FakeApate/pager-kicad/meshpager.kicad_pcb

## KiCad design meshpager.kicad_pcb (2026-08-29)

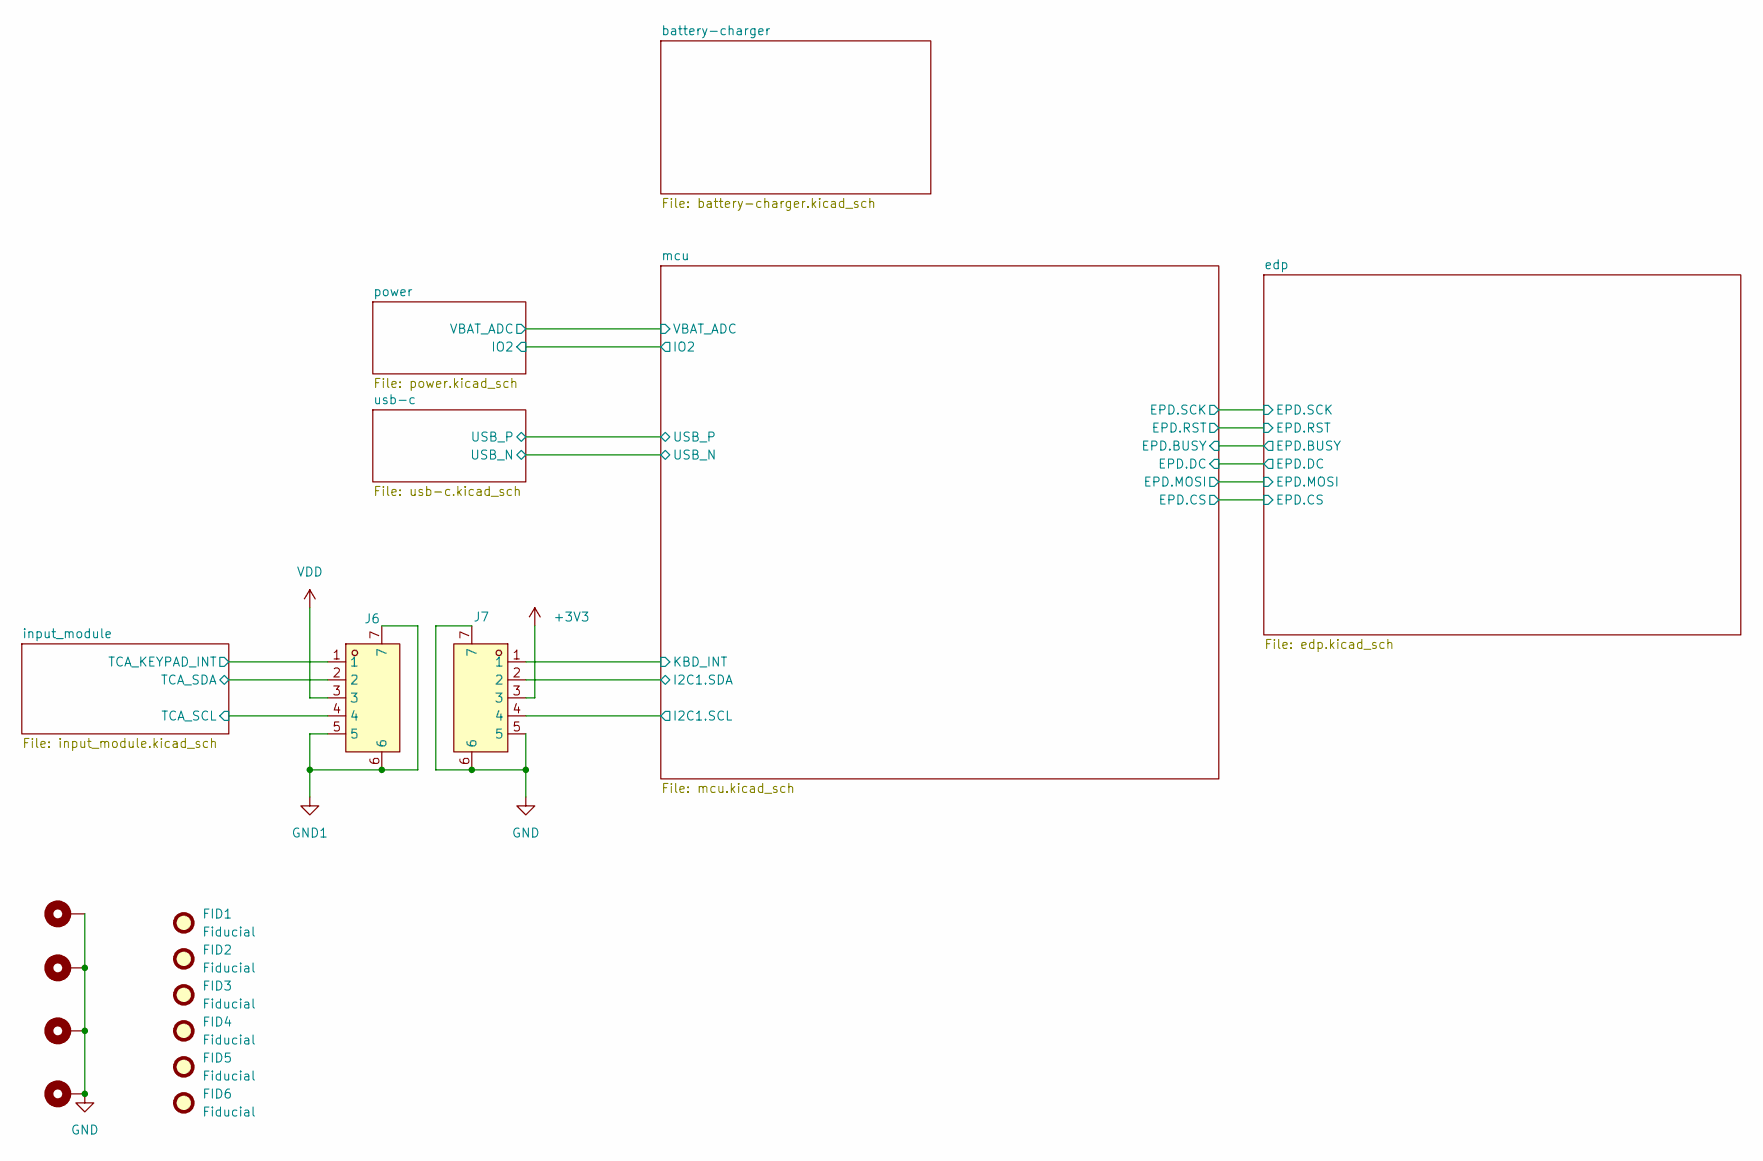
[picture p1: schematic meshpager.kicad_sch]

Parts:
FID1, FID2, FID3, FID4, FID5, FID6: Fiducial; Fiducial_1mm_Mask3mm
H5, H6, H7, H8: MountingHole_Pad; MountingHole_2.7mm_M2.5_Pad
J6, J7: HC-FPC-05-09-5RLTAG; CONN-SMD_5P-P0.50_HCTL_HC-FPC-05-09-5RLTAG; MPN HC-FPC-05-09-5RLTAG; LCSC Part C5213747

Connections:
+3V3: J7.3; also elsewhere on the board
/input_module/INT: J6.1; also elsewhere on the board
/input_module/TCA_SCL: J6.4; also elsewhere on the board
/input_module/TCA_SDA: J6.2; also elsewhere on the board
/mcu/I2C1.SCL: J7.4; also elsewhere on the board
/mcu/I2C1.SDA: J7.2; also elsewhere on the board
/mcu/KBD_INT: J7.1; also elsewhere on the board
GND: H5.1 (1_1), H6.1 (1_1), H7.1 (1_1), H8.1 (1_1), J7.5, J7.6, J7.7; also elsewhere on the board
GND1: J6.5, J6.6, J6.7; also elsewhere on the board
VDD: J6.3; also elsewhere on the board

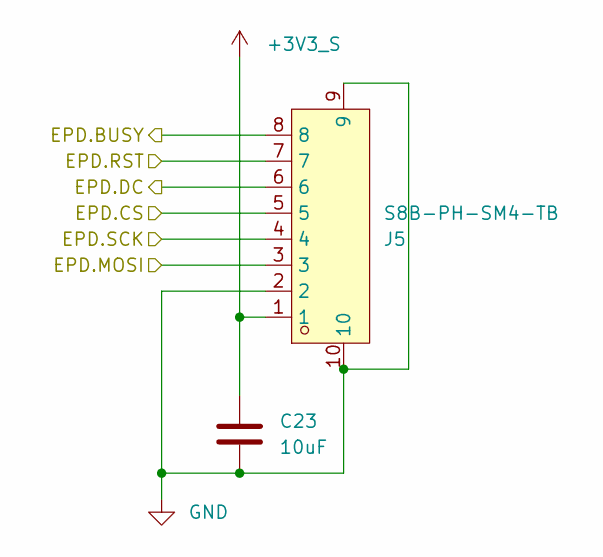
[picture p2: schematic edp.kicad_sch, Meshpager]

Parts:
C23: 10uF; C_0603_1608Metric; LCSC C19702
J5: S8B-PH-SM4-TB; CONN-SMD_8P-P2.00_S8B-PH-SM4-TB-LF-SN; MPN S8B-PH-SM4-TB(LF)(SN); LCSC Part C265121

Connections:
+3V3_S: C23.1, J5.1; also elsewhere on the board
/edp/EPD.BUSY: J5.8; also elsewhere on the board
/edp/EPD.CS: J5.5; also elsewhere on the board
/edp/EPD.DC: J5.6; also elsewhere on the board
/edp/EPD.MOSI: J5.3; also elsewhere on the board
/edp/EPD.RST: J5.7; also elsewhere on the board
/edp/EPD.SCK: J5.4; also elsewhere on the board
GND: C23.2, J5.2, J5.9, J5.10; also elsewhere on the board

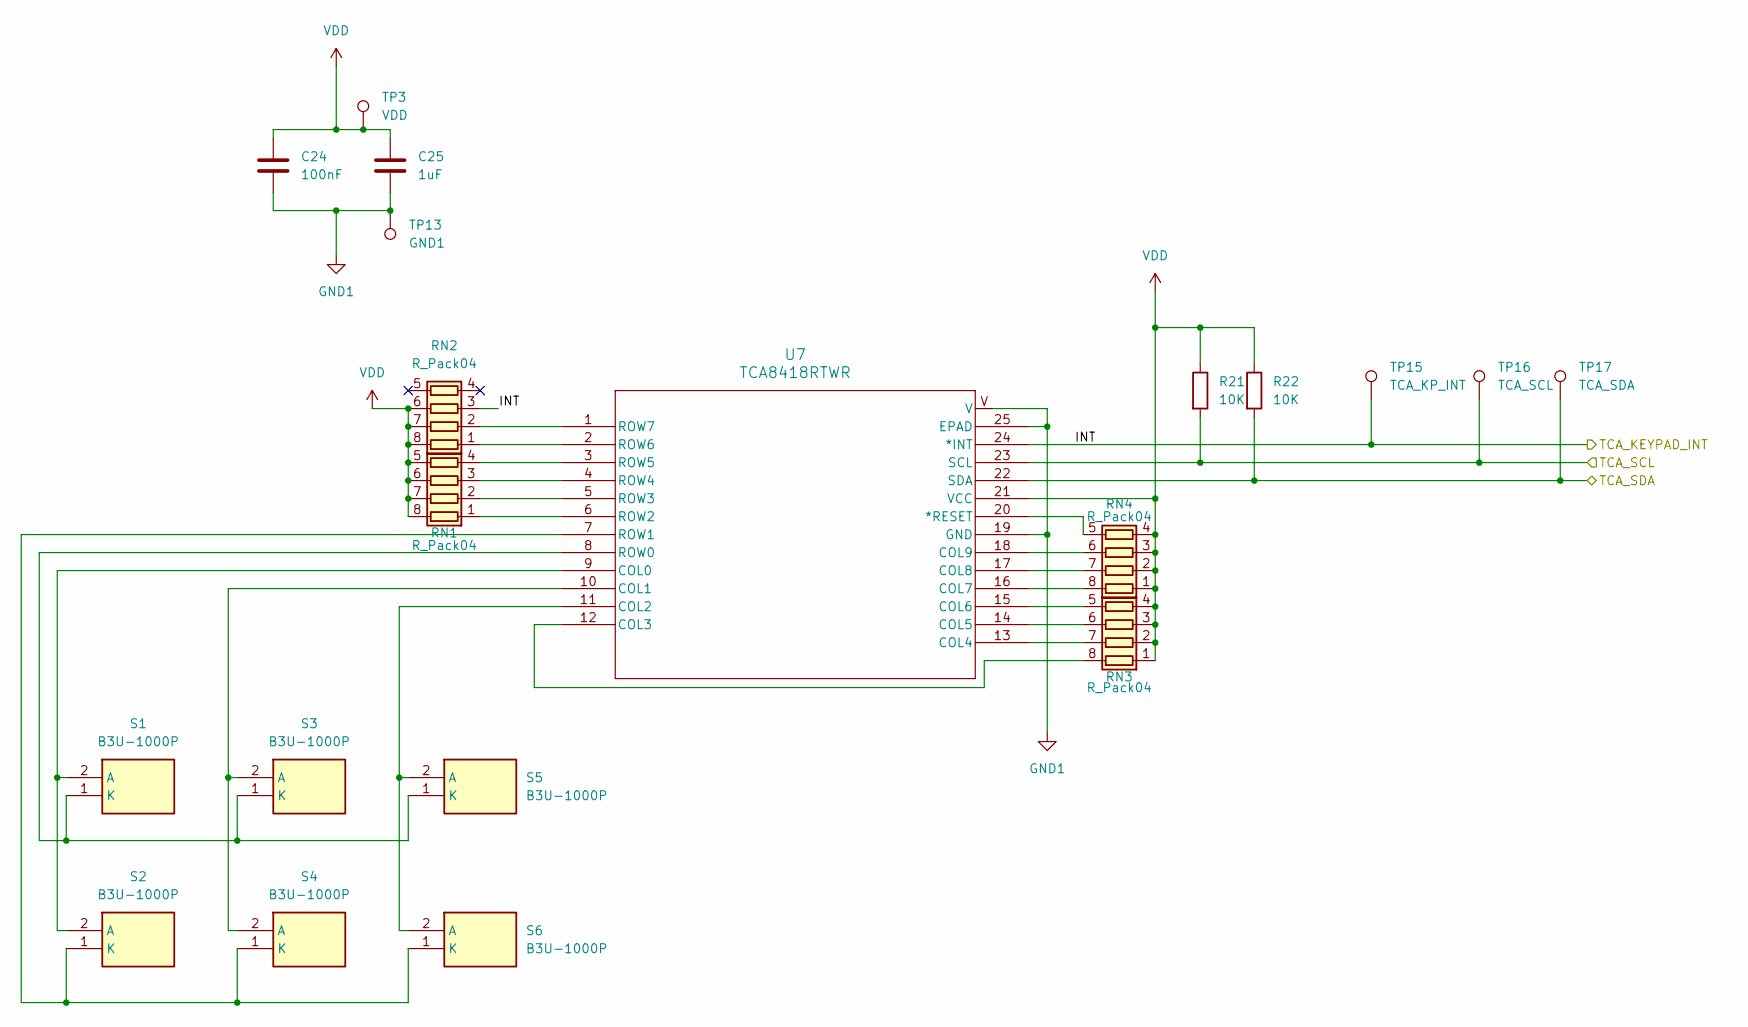
[picture p3: schematic input_module.kicad_sch, Meshpager]

Parts:
C24: 100nF; C_0402_1005Metric; LCSC C1525
C25: 1uF; C_0603_1608Metric; LCSC C15849
R21, R22: 10K; R_0402_1005Metric; LCSC C25744
RN1, RN2, RN3, RN4: R_Pack04; R_Array_Convex_4x0603; LCSC C29718
S1, S2, S3, S4, S5, S6: B3U-1000P; Mouser Part Number 653-B3U-1000P
TP3: VDD; TestPoint_Pad_D1.5mm
TP13: GND1; TestPoint_Pad_D1.5mm
TP15: TCA_KP_INT; TestPoint_Pad_D1.5mm
TP16: TCA_SCL; TestPoint_Pad_D1.5mm
TP17: TCA_SDA; TestPoint_Pad_D1.5mm
U7: TCA8418RTWR; WQFN-24-1EP_4x4mm_P0.5mm_EP2.45x2.45mm; LCSC C138713

Connections:
/input_module/INT: RN2.3 (R3.1), TP15.1 (1_1), U7.24 (*INT); also elsewhere on the board
/input_module/TCA_SCL: R21.2, TP16.1 (1_1), U7.23 (SCL); also elsewhere on the board
/input_module/TCA_SDA: R22.2, TP17.1 (1_1), U7.22 (SDA); also elsewhere on the board
GND1: C24.2, C25.2, TP13.1 (1_1), U7.19 (GND), U7.25 (EPAD), U7.V; also elsewhere on the board
unnamed: RN1.1 (R1.1), U7.6 (ROW2)
unnamed: RN1.2 (R2.1), U7.5 (ROW3)
unnamed: RN1.3 (R3.1), U7.4 (ROW4)
unnamed: RN1.4 (R4.1), U7.3 (ROW5)
unnamed: RN2.1 (R1.1), U7.2 (ROW6)
unnamed: RN2.2 (R2.1), U7.1 (ROW7)
unnamed: RN3.8 (R1.2), U7.12 (COL3)
unnamed: RN3.7 (R2.2), U7.13 (COL4)
unnamed: RN3.6 (R3.2), U7.14 (COL5)
unnamed: RN3.5 (R4.2), U7.15 (COL6)
unnamed: RN4.8 (R1.2), U7.16 (COL7)
unnamed: RN4.7 (R2.2), U7.17 (COL8)
unnamed: RN4.6 (R3.2), U7.18 (COL9)
unnamed: RN4.5 (R4.2), U7.20 (*RESET)
unnamed: S1.2 (A), S2.2 (A), U7.9 (COL0)
unnamed: S1.1 (K), S3.1 (K), S5.1 (K), U7.8 (ROW0)
unnamed: S2.1 (K), S4.1 (K), S6.1 (K), U7.7 (ROW1)
unnamed: S3.2 (A), S4.2 (A), U7.10 (COL1)
unnamed: S5.2 (A), S6.2 (A), U7.11 (COL2)
VDD: C24.1, C25.1, R21.1, R22.1, RN1.5 (R4.2), RN1.6 (R3.2), RN1.7 (R2.2), RN1.8 (R1.2), RN2.6 (R3.2), RN2.7 (R2.2), RN2.8 (R1.2), RN3.1 (R1.1), RN3.2 (R2.1), RN3.3 (R3.1), RN3.4 (R4.1), RN4.1 (R1.1), RN4.2 (R2.1), RN4.3 (R3.1), RN4.4 (R4.1), TP3.1 (1_1), U7.21 (VCC); also elsewhere on the board

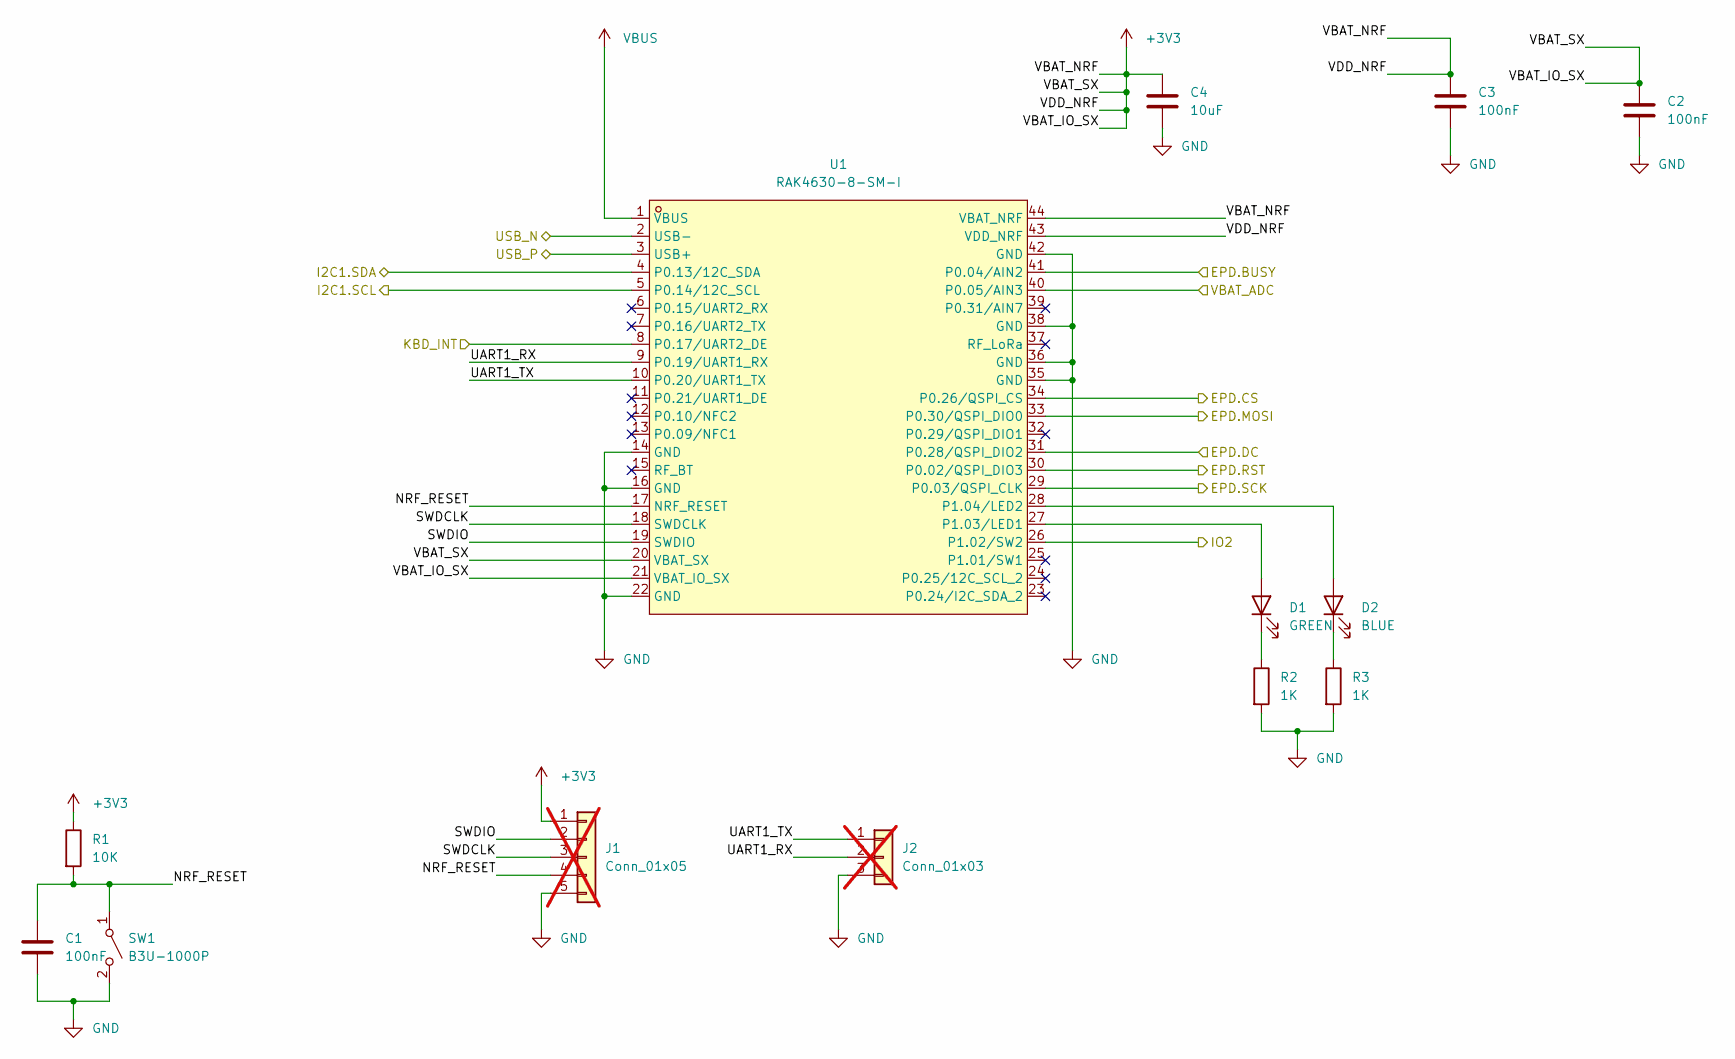
[picture p4: schematic mcu.kicad_sch, Meshpager]

Parts:
C1, C2, C3: 100nF; C_0402_1005Metric; LCSC C1525
C4: 10uF; C_0603_1608Metric; LCSC C19702
D1: GREEN; LED_0603_1608Metric; LCSC C12624
D2: BLUE; LED_0603_1608Metric; LCSC C2288
J1: Conn_01x05; PinHeader_1x05_P1.27mm_Vertical; not fitted
J2: Conn_01x03; PinHeader_1x03_P1.27mm_Vertical; not fitted
R1: 10K; R_0402_1005Metric; LCSC C25744
R2, R3: 1K; R_0402_1005Metric; LCSC C11702
SW1: B3U-1000P; LCSC C231329
U1: RAK4630-8-SM-I; COMM-SMD_44P-L23.0-W15.0-P1.20_RAK4630-8-SM-I; MPN RAk4630-8-SM-I; LCSC Part C32315253

Connections:
+3V3: C2.1, C3.1, C4.1, J1.1, R1.1, U1.20 (VBAT_SX), U1.21 (VBAT_IO_SX), U1.43 (VDD_NRF), U1.44 (VBAT_NRF); also elsewhere on the board
/edp/EPD.BUSY: U1.41 (P0.04/AIN2); also elsewhere on the board
/edp/EPD.CS: U1.34 (P0.26/QSPI_CS); also elsewhere on the board
/edp/EPD.DC: U1.31 (P0.28/QSPI_DIO2); also elsewhere on the board
/edp/EPD.MOSI: U1.33 (P0.30/QSPI_DIO0); also elsewhere on the board
/edp/EPD.RST: U1.30 (P0.02/QSPI_DIO3); also elsewhere on the board
/edp/EPD.SCK: U1.29 (P0.03/QSPI_CLK); also elsewhere on the board
/mcu/I2C1.SCL: U1.5 (P0.14/12C_SCL); also elsewhere on the board
/mcu/I2C1.SDA: U1.4 (P0.13/12C_SDA); also elsewhere on the board
/mcu/IO2: U1.26 (P1.02/SW2); also elsewhere on the board
/mcu/KBD_INT: U1.8 (P0.17/UART2_DE); also elsewhere on the board
/mcu/NRF_RESET: C1.1, J1.4, R1.2, SW1.1 (A), U1.17 (NRF_RESET)
/mcu/SWDCLK: J1.3, U1.18 (SWDCLK)
/mcu/SWDIO: J1.2, U1.19 (SWDIO)
/mcu/UART1_RX: J2.2, U1.9 (P0.19/UART1_RX)
/mcu/UART1_TX: J2.1, U1.10 (P0.20/UART1_TX)
/mcu/USB_N: U1.2 (USB-); also elsewhere on the board
/mcu/USB_P: U1.3 (USB+); also elsewhere on the board
/mcu/VBAT_ADC: U1.40 (P0.05/AIN3); also elsewhere on the board
GND: C1.2, C2.2, C3.2, C4.2, J1.5, J2.3, R2.2, R3.2, SW1.2 (B), U1.14 (GND), U1.16 (GND), U1.22 (GND), U1.35 (GND), U1.36 (GND), U1.38 (GND), U1.42 (GND); also elsewhere on the board
unnamed: D1.2 (A), U1.27 (P1.03/LED1)
unnamed: D1.1 (K), R2.1
unnamed: D2.2 (A), U1.28 (P1.04/LED2)
unnamed: D2.1 (K), R3.1
VBUS: U1.1 (VBUS); also elsewhere on the board

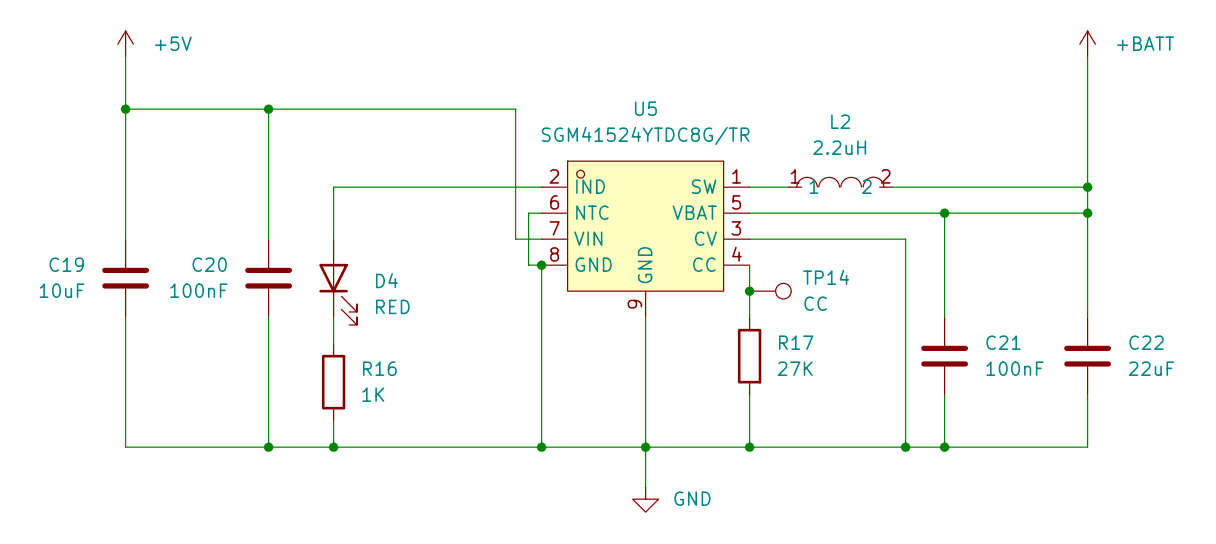
[picture p5: schematic battery-charger.kicad_sch, Meshpager]

Parts:
C19: 10uF; C_0603_1608Metric; LCSC C19702
C20, C21: 100nF; C_0402_1005Metric; LCSC C1525
C22: 22uF; C_0805_2012Metric; LCSC C45783
D4: RED; LED_0603_1608Metric; LCSC C2286
L2: 2.2uH; IND-SMD_L3.0-W3.0_SWPA3010S; MPN SWPA3012S2R2MT; LCSC Part C36402
R16: 1K; R_0402_1005Metric; LCSC C11702
R17: 27K; R_0402_1005Metric; LCSC C2933084
TP14: CC; TestPoint_Pad_D1.5mm
U5: SGM41524YTDC8G/TR; DFN-8_L3.0-W2.0-P0.50-TL-EP-1; MPN SGM41524YTDC8G/TR; LCSC Part C699852

Connections:
+5V: C19.2, C20.1, U5.7 (VIN); also elsewhere on the board
+BATT: C21.1, C22.2, L2.2, U5.5 (VBAT); also elsewhere on the board
GND: C19.1, C20.2, C21.2, C22.1, R16.1, R17.2, U5.3 (CV), U5.6 (NTC), U5.8 (GND), U5.9 (GND); also elsewhere on the board
unnamed: D4.2 (A), U5.2 (IND)
unnamed: D4.1 (K), R16.2
unnamed: R17.1, TP14.1 (1_1), U5.4 (CC)
unnamed: L2.1, U5.1 (SW)

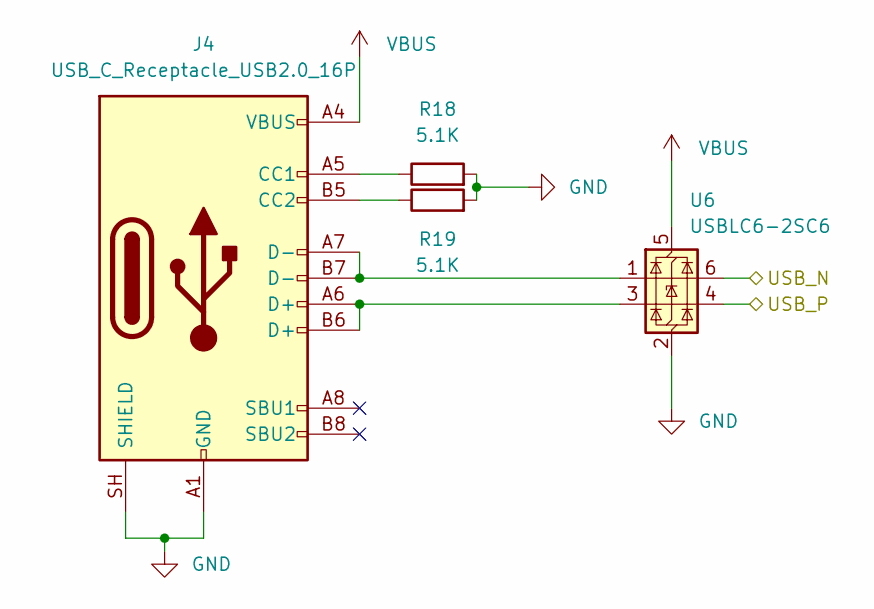
[picture p6: schematic usb-c.kicad_sch, Meshpager]

Parts:
J4: USB_C_Receptacle_USB2.0_16P; USB_C_Receptacle_G-Switch_GT-USB-7010ASV; LCSC Part C2988369
R18, R19: 5.1K; R_0402_1005Metric; LCSC C25905
U6: USBLC6-2SC6; SOT-23-6; LCSC C7519

Connections:
/mcu/USB_N: U6.6 (I/O1); also elsewhere on the board
/mcu/USB_P: U6.4 (I/O2); also elsewhere on the board
GND: J4.A1 (GND), J4.A12 (GND), J4.B1 (GND), J4.B12 (GND), J4.SH (SHIELD), R18.2, R19.2, U6.2 (GND); also elsewhere on the board
unnamed: J4.A5 (CC1), R18.1
unnamed: J4.B5 (CC2), R19.1
unnamed: J4.A6 (D+), J4.B6 (D+), U6.3 (I/O2)
unnamed: J4.A7 (D-), J4.B7 (D-), U6.1 (I/O1)
VBUS: J4.A4 (VBUS), J4.A9 (VBUS), J4.B4 (VBUS), J4.B9 (VBUS), U6.5 (VBUS); also elsewhere on the board

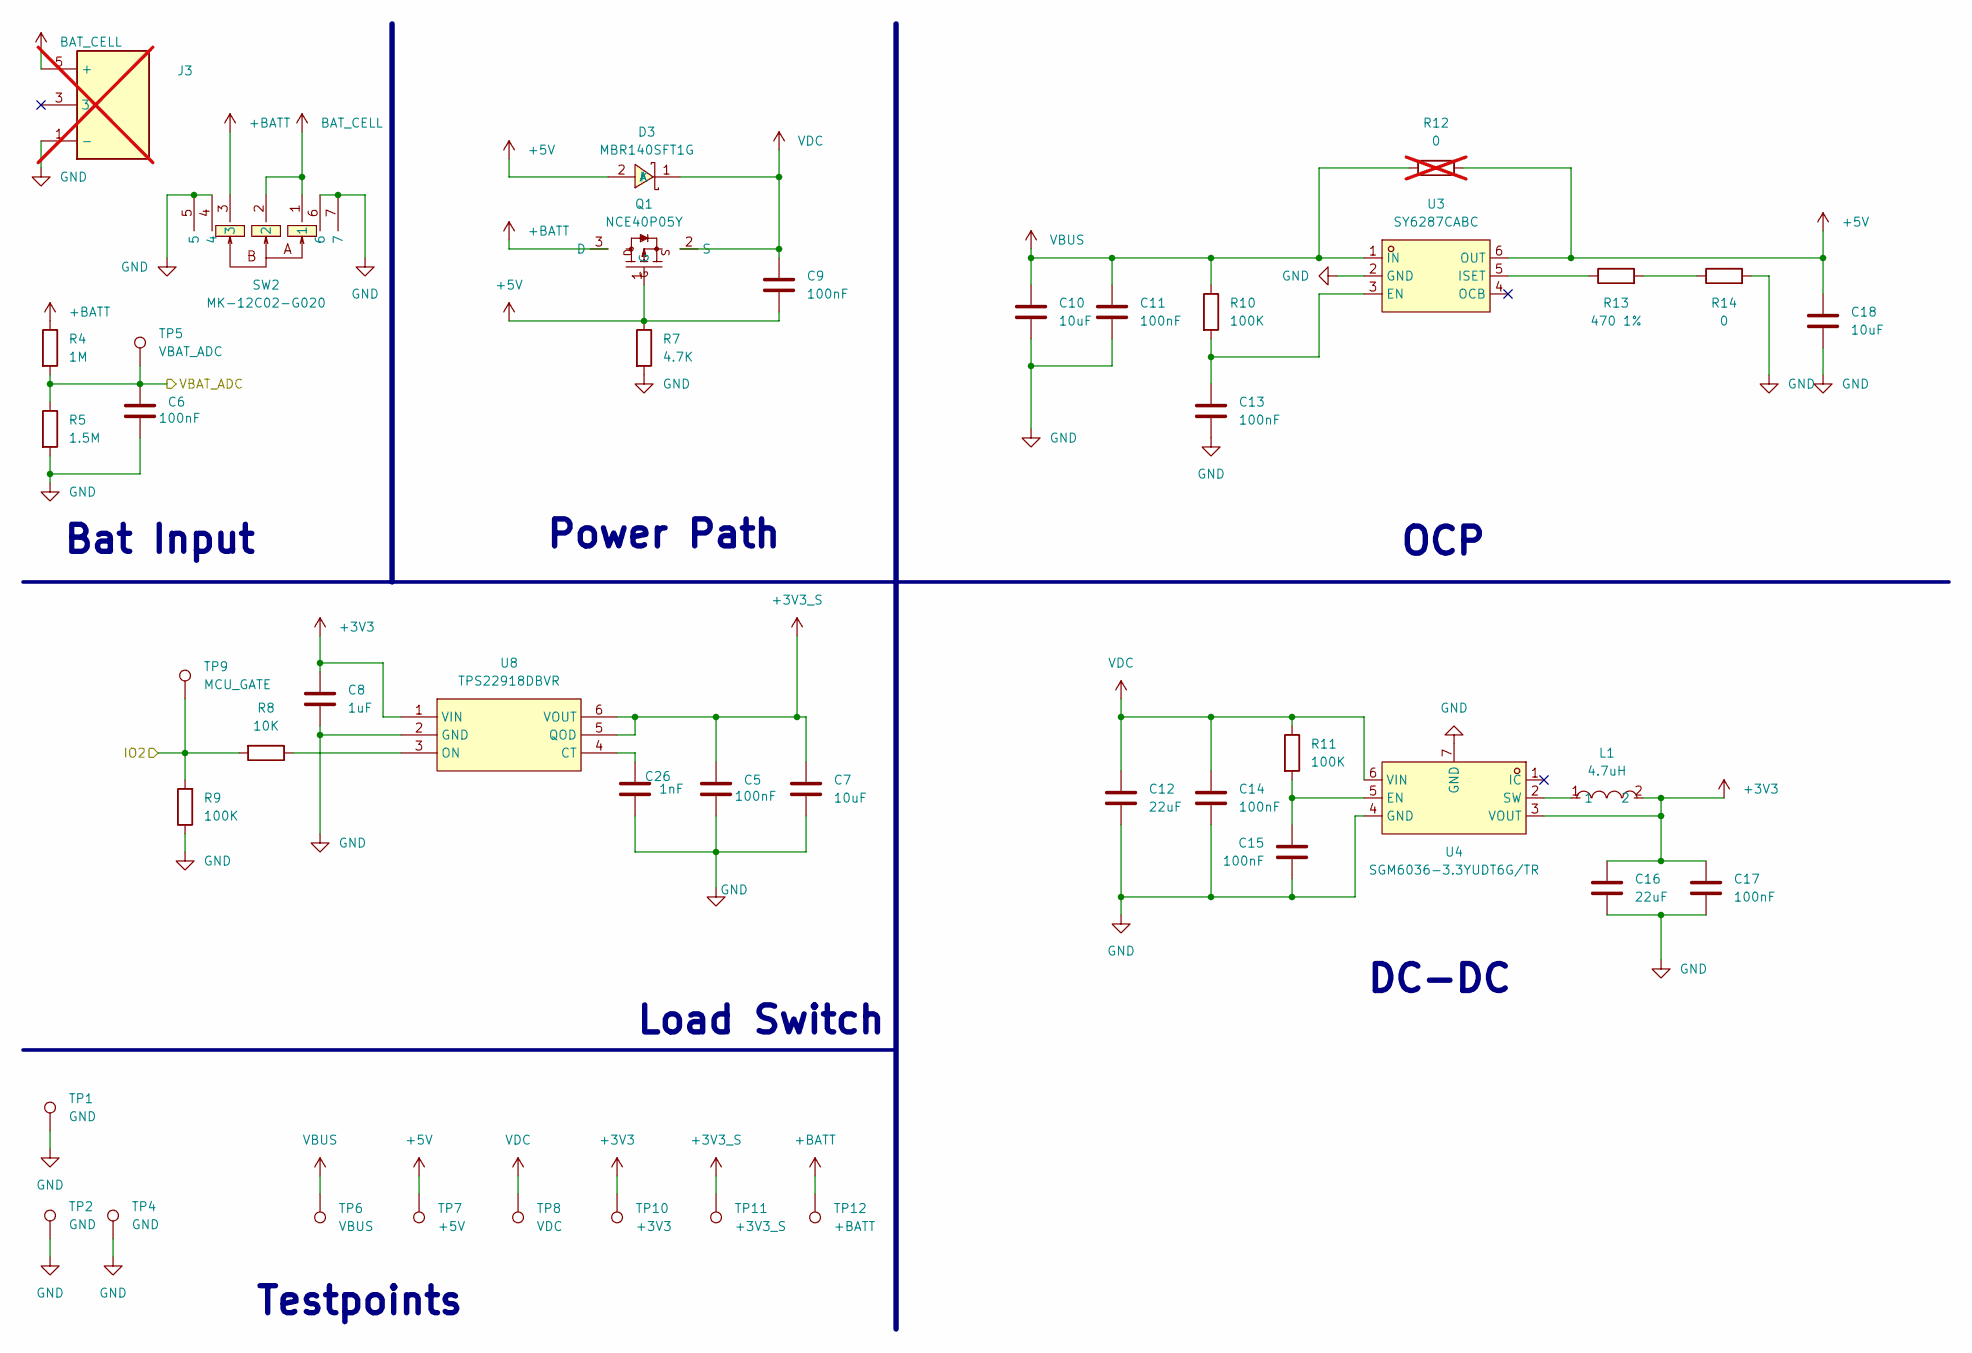
[picture p7: schematic power.kicad_sch, Meshpager]

Parts:
C5, C6, C9, C11, C13, C14, C15, C17: 100nF; C_0402_1005Metric; LCSC C1525
C7, C10, C18: 10uF; C_0603_1608Metric; LCSC C19702
C8: 1uF; C_0603_1608Metric; LCSC C15849
C12, C16: 22uF; C_0805_2012Metric; LCSC C45783
C26: 1nF; C_0402_1005Metric
D3: MBR140SFT1G; SOD-123F_L2.8-W1.8-LS3.7-RD; MPN MBR140SFT1G; LCSC Part C43381
J3: 009155003301006; Mouser Part Number 581-009155003301006; not fitted
L1: 4.7uH; IND-SMD_L3.0-W3.0_FNR30XXS; MPN SWPA3012S4R7MT; LCSC Part C83415
Q1: NCE40P05Y; SOT-23-3_L2.9-W1.6-P1.90-LS2.8-BR; MPN NCE40P05Y; LCSC Part C163738
R4: 1M; R_0402_1005Metric; LCSC C26083
R5: 1.5M; R_0402_1005Metric; LCSC C22276
R7: 4.7K; R_0402_1005Metric; LCSC C25900
R8: 10K; R_0402_1005Metric; LCSC C25744
R9, R10, R11: 100K; R_0402_1005Metric; LCSC C25741
R12: 0; R_0805_2012Metric_Pad1.20x1.40mm_HandSolder; LCSC C17477; not fitted
R13: 470 1%; R_0402_1005Metric; LCSC C25117
R14: 0; R_0805_2012Metric_Pad1.20x1.40mm_HandSolder; LCSC C17477
SW2: MK-12C02-G020; SW-SMD_MK-12C02-G020; MPN MK-12C02-G020; LCSC Part C963206
TP1, TP2, TP4: GND; TestPoint_Pad_D1.5mm
TP5: VBAT_ADC; TestPoint_Pad_D1.5mm
TP6: VBUS; TestPoint_Pad_D1.5mm
TP7: +5V; TestPoint_Pad_D1.5mm
TP8: VDC; TestPoint_Pad_D1.5mm
TP9: MCU_GATE; TestPoint_Pad_D1.5mm
TP10: +3V3; TestPoint_Pad_D1.5mm
TP11: +3V3_S; TestPoint_Pad_D1.5mm
TP12: +BATT; TestPoint_Pad_D1.5mm
U3: SY6287CABC; SOT-23-6_L2.9-W1.6-P0.95-LS2.9-BL; MPN SY6287CABC; LCSC Part C3013652
U4: SGM6036-3.3YUDT6G/TR; UTDFN-6_L2.0-W1.5-P0.50-BL-EP; MPN SGM6036-3.3YUDT6G/TR; LCSC Part C5153601
U8: TPS22918DBVR; SOT-23-6_L2.9-W1.6-P0.95-LS2.8-BR; MPN TPS22918DBVR; LCSC Part C131941

Connections:
+3V3: C8.1, C16.2, C17.2, L1.2, TP10.1 (1_1), U4.3 (VOUT), U8.1 (VIN); also elsewhere on the board
+3V3_S: C5.1, C7.1, TP11.1 (1_1), U8.5 (QOD), U8.6 (VOUT); also elsewhere on the board
+5V: C9.2, C18.1, D3.2 (A), Q1.1 (G), R7.1, R12.2, TP7.1 (1_1), U3.6 (OUT); also elsewhere on the board
+BATT: Q1.3 (D), R4.1, SW2.3, TP12.1 (1_1); also elsewhere on the board
/mcu/IO2: R8.2, R9.2, TP9.1 (1_1); also elsewhere on the board
/mcu/VBAT_ADC: C6.1, R4.2, R5.1, TP5.1 (1_1); also elsewhere on the board
BAT_CELL: J3.5 (+), SW2.1, SW2.2
GND: C5.2, C6.2, C7.2, C8.2, C10.2, C11.2, C12.2, C13.2, C14.2, C15.2, C16.1, C17.1, C18.2, C26.2, J3.1 (-), R5.2, R7.2, R9.1, R14.2, SW2.4, SW2.5, SW2.6, SW2.7, TP1.1 (1_1), TP2.1 (1_1), TP4.1 (1_1), U3.2 (GND), U4.4 (GND), U4.7 (GND), U8.2 (GND); also elsewhere on the board
unnamed: R13.2, R14.1
unnamed: C13.1, R10.2, U3.3 (EN)
unnamed: R13.1, U3.5 (ISET)
unnamed: C15.1, R11.2, U4.5 (EN)
unnamed: L1.1, U4.2 (SW)
unnamed: C26.1, U8.4 (CT)
unnamed: R8.1, U8.3 (ON)
VBUS: C10.1, C11.1, R10.1, R12.1, TP6.1 (1_1), U3.1 (IN); also elsewhere on the board
VDC: C9.1, C12.1, C14.1, D3.1 (K), Q1.2 (S), R11.1, TP8.1 (1_1), U4.6 (VIN)

Notes on the sheet:
Load Switch
OCP
Power Path
DC-DC
Bat Input
Testpoints

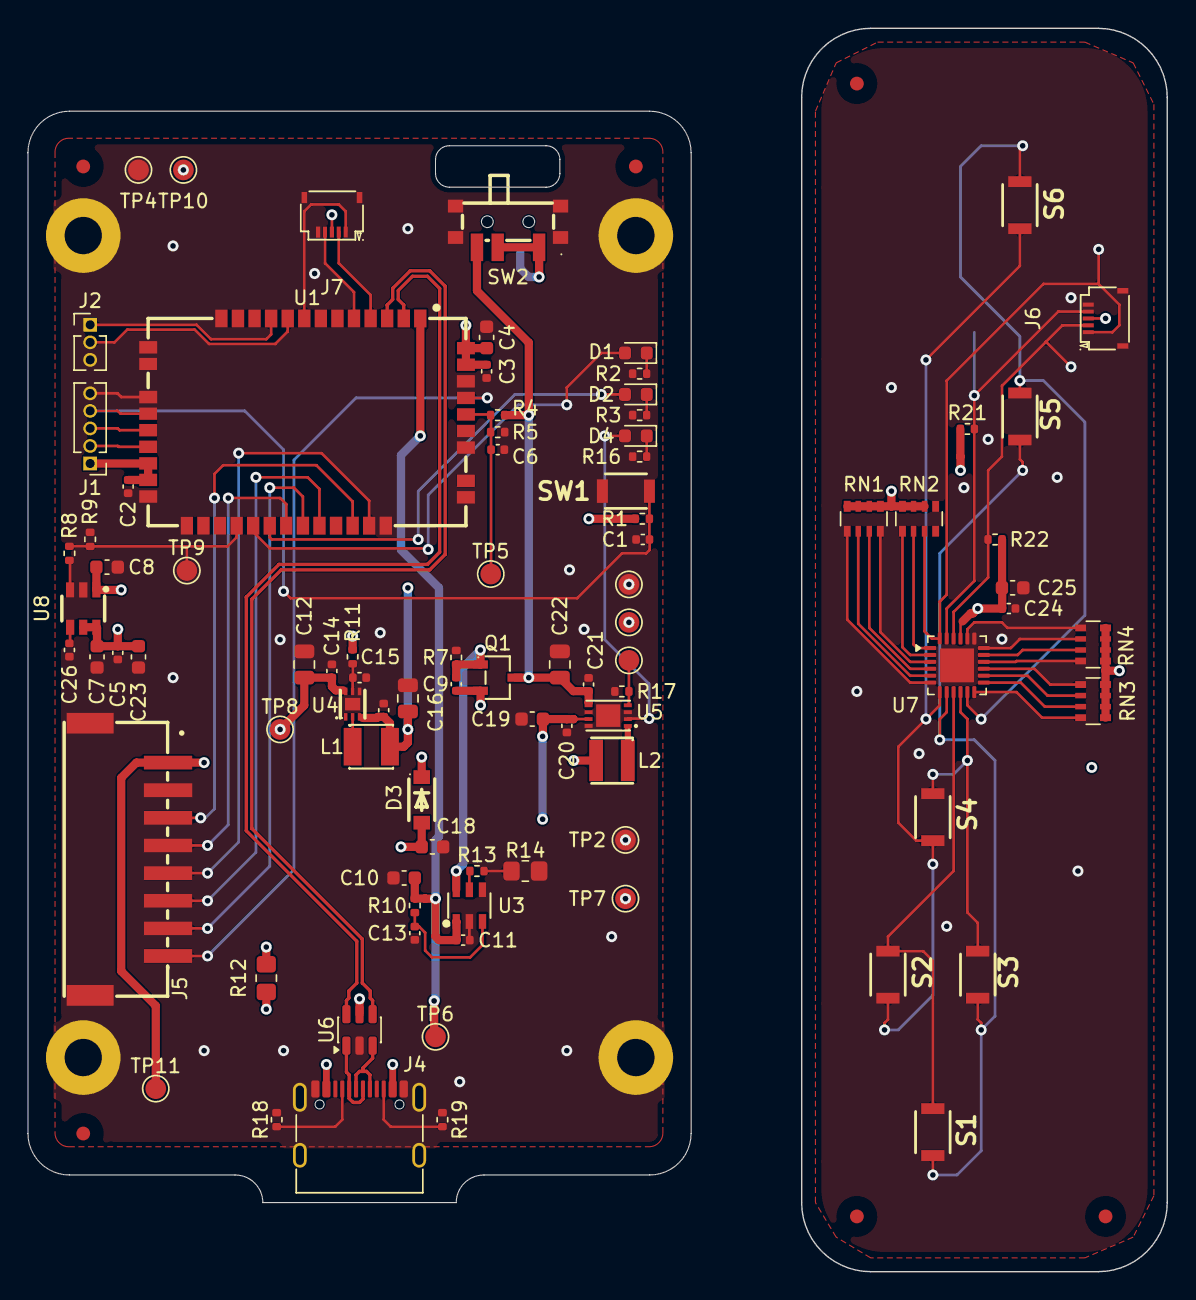
[picture p8: board meshpager.kicad_pcb from above]

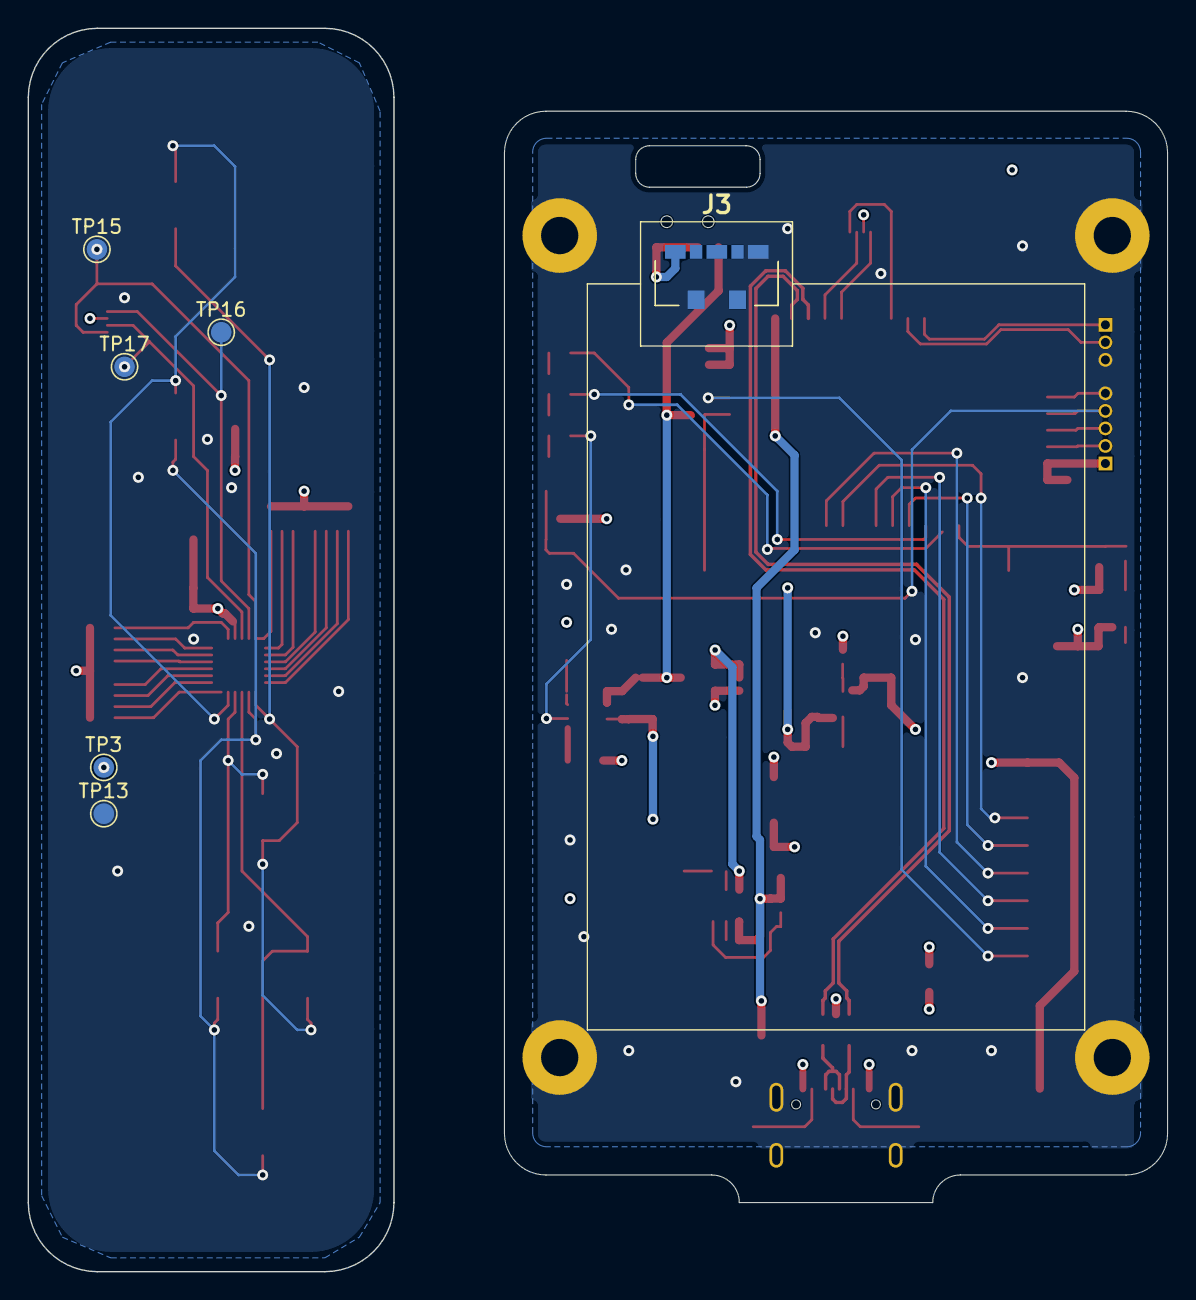
[picture p9: board meshpager.kicad_pcb from below]

Board: 4 copper layers, 82.5 x 90.0 mm, 107 parts (6 on the bottom side), 69 nets.

Other parts of the board:
Input: Board
Main: Board
