FakeApate/pager-kicad/(commit log)

2026-08-23 rename project
    [battery-charger.kicad_sch, mcu.kicad_sch, meshpager.kicad_pcb, meshpager.kicad_sch]
2026-08-25 Pretty cool now
    [input_module.kicad_sch, meshpager.kicad_pcb, meshpager.kicad_sch, power.kicad_sch]
